MR-DOS/8052-schizoid_demo/PICS/schizoid.png

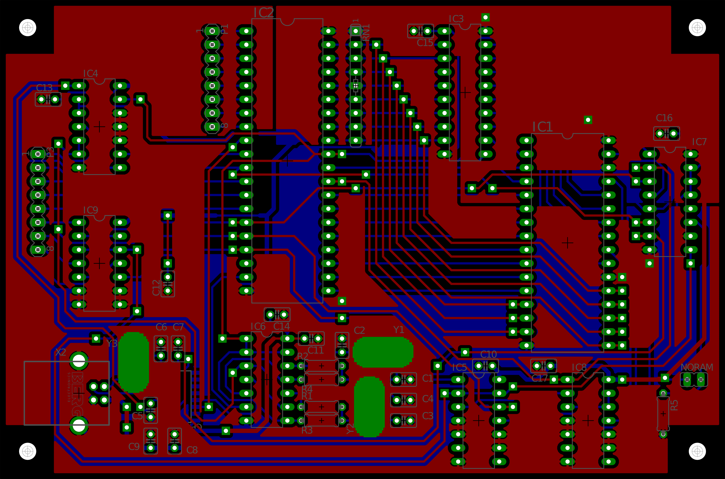
PICS/schizoid.png
