MR-DOS/8052-schizoid_demo/HW_makedata/board_preview.pdf

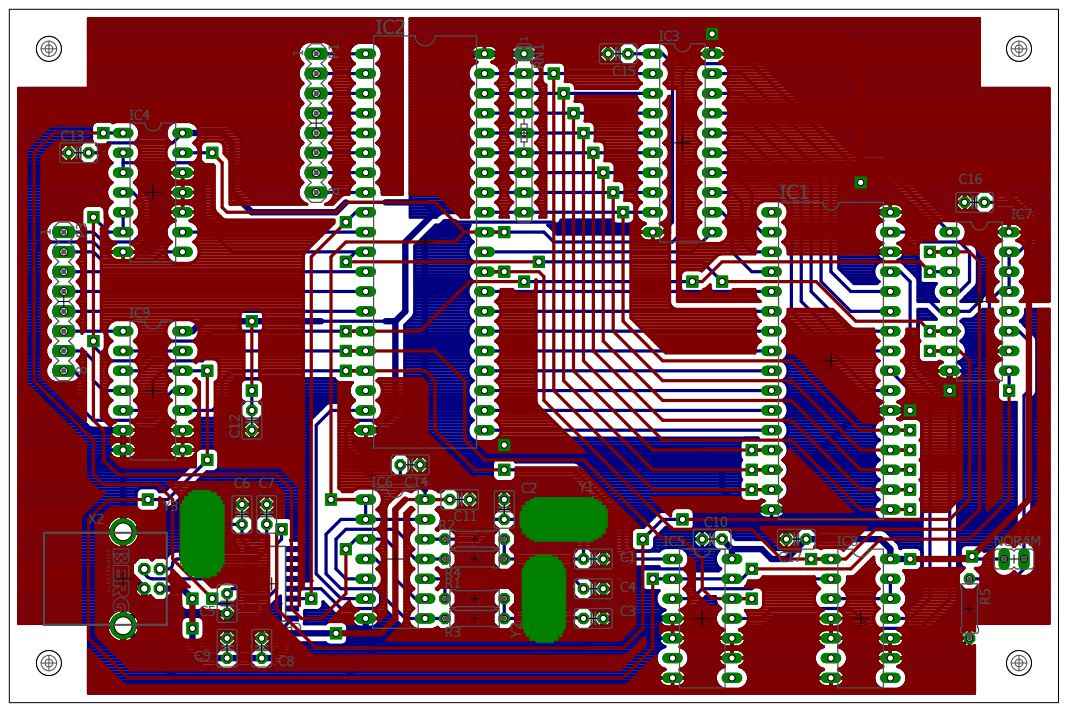
[picture p3: page 1]
