MR-DOS/8052-schizoid_demo/HW_makedata/pcb_placement.pdf

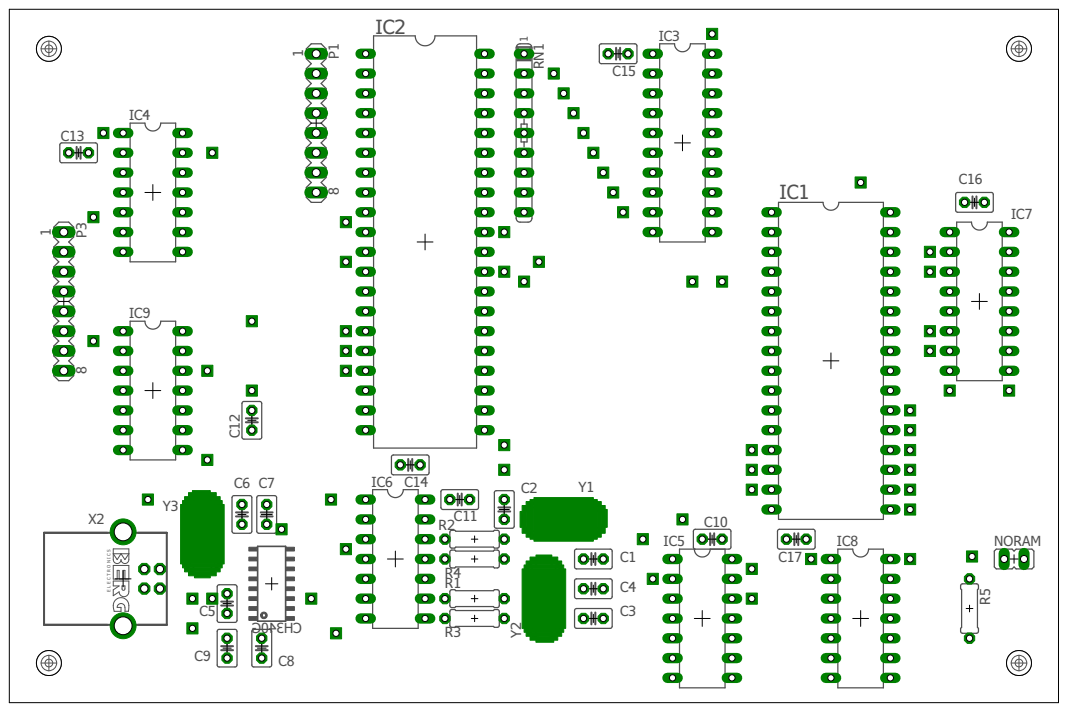
[picture p4: page 1]
