MR-DOS/8052-schizoid_demo/HW_makedata/pcb_top_bottom.pdf

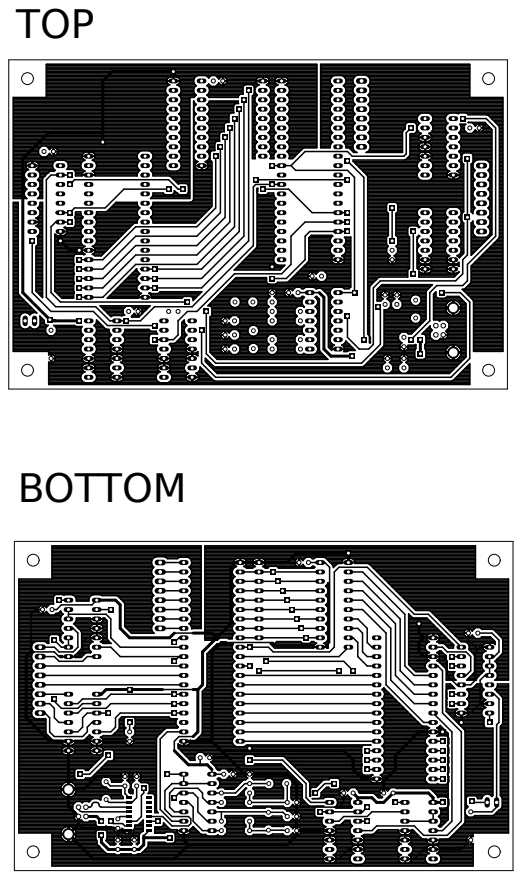
[picture p5: page 1]
TOP; BOTTOM
