MR-DOS/8052-schizoid_demo/HW_makedata/schematics.pdf

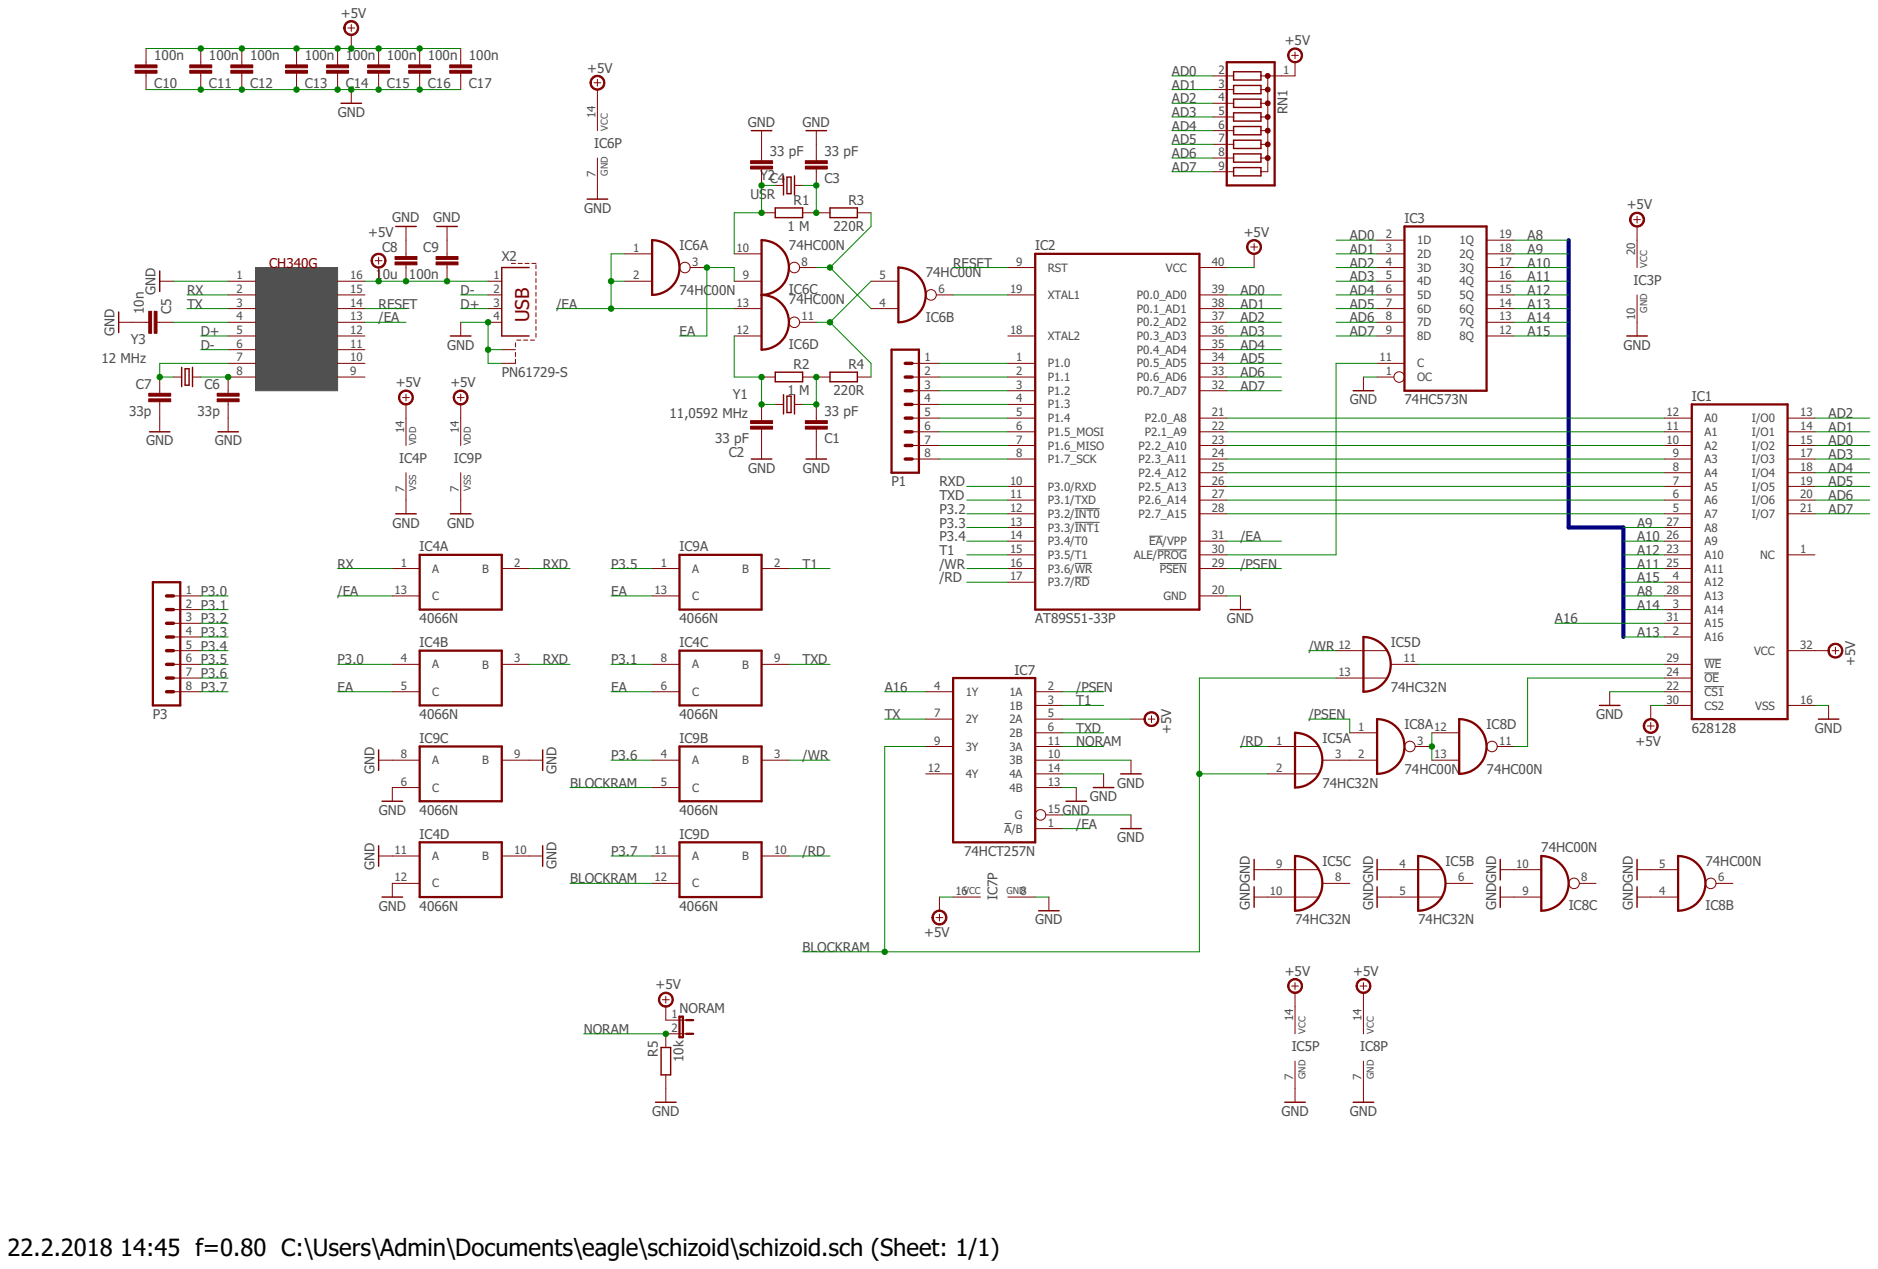
[picture p6: page 1]

22.2.2018 14:45 f=0.80 C:\Users\Admin\Documents\eagle\schizoid\schizoid.sch (Sheet: 1/1)
