MR-DOS/8052-schizoid_demo/HW_eagle/schizoid.brd

## EAGLE design HW_eagle/schizoid.brd (2018-03-31)

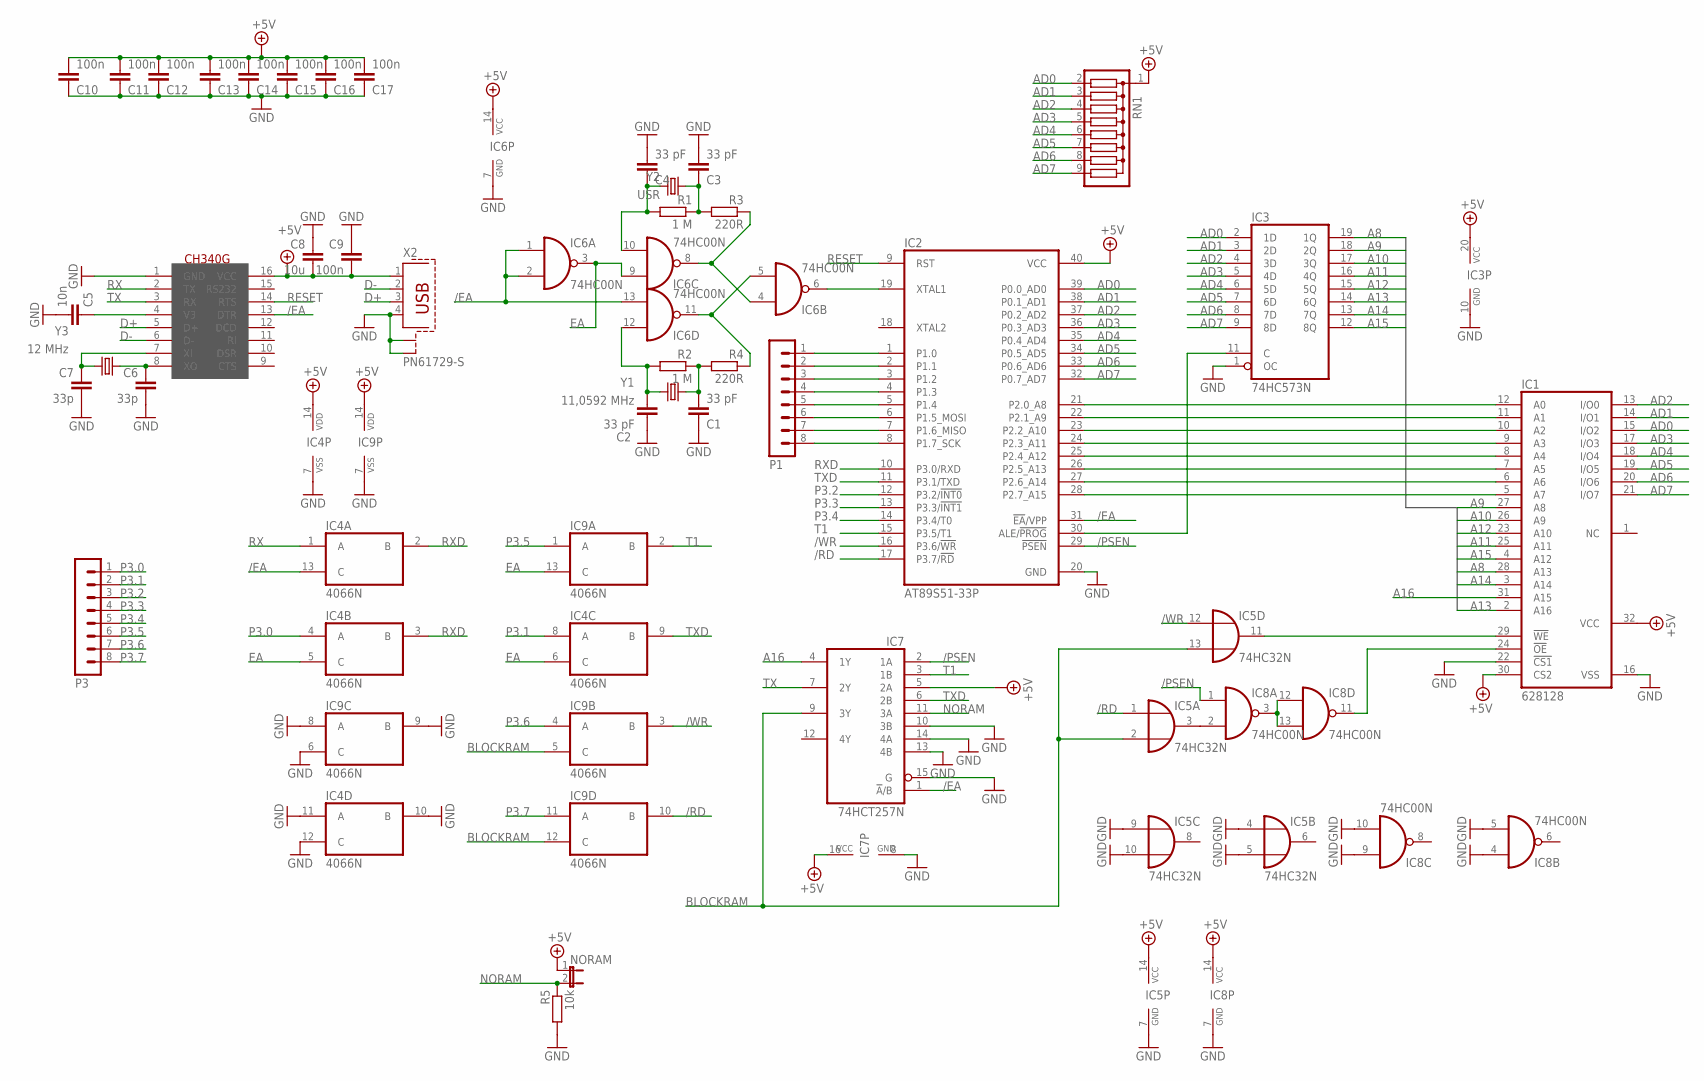
[picture p7: schematic schizoid.sch]

Parts:
C1, C2, C3, C4: 33 pF; C025-025X050
C5: 10n; C025-025X050
C6, C7: 33p; C025-025X050
C8: 10u; C025-025X050
C9, C10, C11, C12, C13, C14, C15, C16, C17: 100n; C025-025X050
IC1: 628128; DIL32
IC2: AT89S51-33P; DIL40
IC3: 74HC573N; DIL20
IC4, IC9: 4066N; DIL14
IC5: 74HC32N; DIL14
IC6, IC8: 74HC00N; DIL14
IC7: 74HCT257N; DIL16
NORAM: JP1E; JP1
P1, P3: MA08-1
R1, R2: 1 M; 0207/7
R3, R4: 220R; 0207/7
R5: 10k; 0207/7
RN1: G08R; SIL9
U$1: CH340G; SOIC16
X2: PN61729-S
Y1: 11,0592 MHz; HC49U-V
Y2: USR; HC49U-V
Y3: 12 MHz; HC49U-V

Connections:
+5V: C8.2, C9.2, C10.2, C11.2, C12.2, C13.2, C14.2, C15.2, C16.2, C17.2, IC1.30 (CS2), IC1.32 (VCC), IC2.40 (VCC), IC3.20 (VCC), IC4.14 (VDD), IC5.14 (VCC), IC6.14 (VCC), IC7.5 (2A), IC7.16 (VCC), IC8.14 (VCC), IC9.14 (VDD), NORAM.1, RN1.1, U$1.16 (VCC), X2.1
/EA: IC2.31 (!EA!/VPP), IC4.13 (C), IC6.1 (I0), IC6.2 (I1), IC6.13 (I1), IC7.1 (!A!/B), U$1.13 (DTR)
/PSEN: IC2.29 (!PSEN), IC7.2 (1A), IC8.1 (I0)
/RD: IC2.17 (P3.7/!RD), IC5.1 (I0), IC9.10 (B)
/WR: IC2.16 (P3.6/!WR), IC5.12 (I0), IC9.3 (B)
A8: IC1.28 (A13), IC3.19 (1Q)
A9: IC1.27 (A8), IC3.18 (2Q)
A10: IC1.26 (A9), IC3.17 (3Q)
A11: IC1.25 (A11), IC3.16 (4Q)
A12: IC1.23 (A10), IC3.15 (5Q)
A13: IC1.2 (A16), IC3.14 (6Q)
A14: IC1.3 (A14), IC3.13 (7Q)
A15: IC1.4 (A12), IC3.12 (8Q)
A16: IC1.31 (A15), IC7.4 (1Y)
AD0: IC1.15 (I/O2), IC2.39 (P0.0_AD0), IC3.2 (1D), RN1.2
AD1: IC1.14 (I/O1), IC2.38 (P0.1_AD1), IC3.3 (2D), RN1.3
AD2: IC1.13 (I/O0), IC2.37 (P0.2_AD2), IC3.4 (3D), RN1.4
AD3: IC1.17 (I/O3), IC2.36 (P0.3_AD3), IC3.5 (4D), RN1.5
AD4: IC1.18 (I/O4), IC2.35 (P0.4_AD4), IC3.6 (5D), RN1.6
AD5: IC1.19 (I/O5), IC2.34 (P0.5_AD5), IC3.7 (6D), RN1.7
AD6: IC1.20 (I/O6), IC2.33 (P0.6_AD6), IC3.8 (7D), RN1.8
AD7: IC1.21 (I/O7), IC2.32 (P0.7_AD7), IC3.9 (8D), RN1.9
BLOCKRAM: IC5.2 (I1), IC5.13 (I1), IC7.9 (3Y), IC9.5 (C), IC9.12 (C)
D+: U$1.5 (D+), X2.3
D-: U$1.6 (D-), X2.2
EA: IC4.5 (C), IC4.6 (C), IC6.3 (O), IC6.9 (I0), IC9.13 (C)
GND: C1.1, C2.1, C3.2, C4.2, C5.2, C6.2, C7.2, C8.1, C9.1, C10.1, C11.1, C12.1, C13.1, C14.1, C15.1, C16.1, C17.1, IC1.16 (VSS), IC1.22 (!CS1), IC2.20 (GND), IC3.1 (OC), IC3.10 (GND), IC4.7 (VSS), IC4.10 (B), IC4.11 (A), IC4.12 (C), IC5.4 (I0), IC5.5 (I1), IC5.7 (GND), IC5.9 (I0), IC5.10 (I1), IC6.7 (GND), IC7.8 (GND), IC7.10 (3B), IC7.13 (4B), IC7.14 (4A), IC7.15 (G), IC8.4 (I0), IC8.5 (I1), IC8.7 (GND), IC8.9 (I0), IC8.10 (I1), IC9.6 (C), IC9.7 (VSS), IC9.8 (A), IC9.9 (B), R5.2, U$1.1 (GND), X2.4, X2.S1, X2.S2
unnamed: IC1.12 (A0), IC2.21 (P2.0_A8)
unnamed: IC1.11 (A1), IC2.22 (P2.1_A9)
unnamed: IC1.10 (A2), IC2.23 (P2.2_A10)
unnamed: IC1.9 (A3), IC2.24 (P2.3_A11)
unnamed: IC1.8 (A4), IC2.25 (P2.4_A12)
unnamed: IC1.7 (A5), IC2.26 (P2.5_A13)
unnamed: IC1.6 (A6), IC2.27 (P2.6_A14)
unnamed: IC1.5 (A7), IC2.28 (P2.7_A15)
unnamed: IC2.30 (ALE/!PROG), IC3.11 (C)
unnamed: C3.1, R1.1, R3.2, Y2.1
unnamed: IC2.1 (P1.0), P1.1
unnamed: C1.2, R2.1, R4.2, Y1.1
unnamed: IC2.2 (P1.1), P1.2
unnamed: IC2.3 (P1.2), P1.3
unnamed: IC2.4 (P1.3), P1.4
unnamed: IC2.5 (P1.4), P1.5
unnamed: IC2.6 (P1.5_MOSI), P1.6
unnamed: IC2.7 (P1.6_MISO), P1.7
unnamed: IC5.3 (O), IC8.2 (I1)
unnamed: IC6.4 (I0), IC6.8 (O), R3.1
unnamed: IC8.3 (O), IC8.12 (I0), IC8.13 (I1)
unnamed: IC6.5 (I1), IC6.11 (O), R4.1
unnamed: C2.2, IC6.12 (I0), R2.2, Y1.2
unnamed: IC2.8 (P1.7_SCK), P1.8
unnamed: C4.1, IC6.10 (I1), R1.2, Y2.2
unnamed: IC2.19 (XTAL1), IC6.6 (O)
unnamed: C5.1, U$1.4 (V3)
unnamed: C6.1, U$1.8 (XO), Y3.1
unnamed: C7.1, U$1.7 (XI), Y3.2
unnamed: IC1.29 (!WE), IC5.11 (O)
unnamed: IC1.24 (!OE), IC8.11 (O)
NORAM: IC7.11 (3A), NORAM.2, R5.1
P3.0: IC4.4 (A), P3.1
P3.1: IC4.8 (A), P3.2
P3.2: IC2.12 (P3.2/!INT0), P3.3
P3.3: IC2.13 (P3.3/!INT1), P3.4
P3.4: IC2.14 (P3.4/T0), P3.5
P3.5: IC9.1 (A), P3.6
P3.6: IC9.4 (A), P3.7
P3.7: IC9.11 (A), P3.8
RESET: IC2.9 (RST), U$1.14 (RTS)
RX: IC4.1 (A), U$1.2 (TX)
RXD: IC2.10 (P3.0/RXD), IC4.2 (B), IC4.3 (B)
T1: IC2.15 (P3.5/T1), IC7.3 (1B), IC9.2 (B)
TX: IC7.7 (2Y), U$1.3 (RX)
TXD: IC2.11 (P3.1/TXD), IC4.9 (B), IC7.6 (2B)

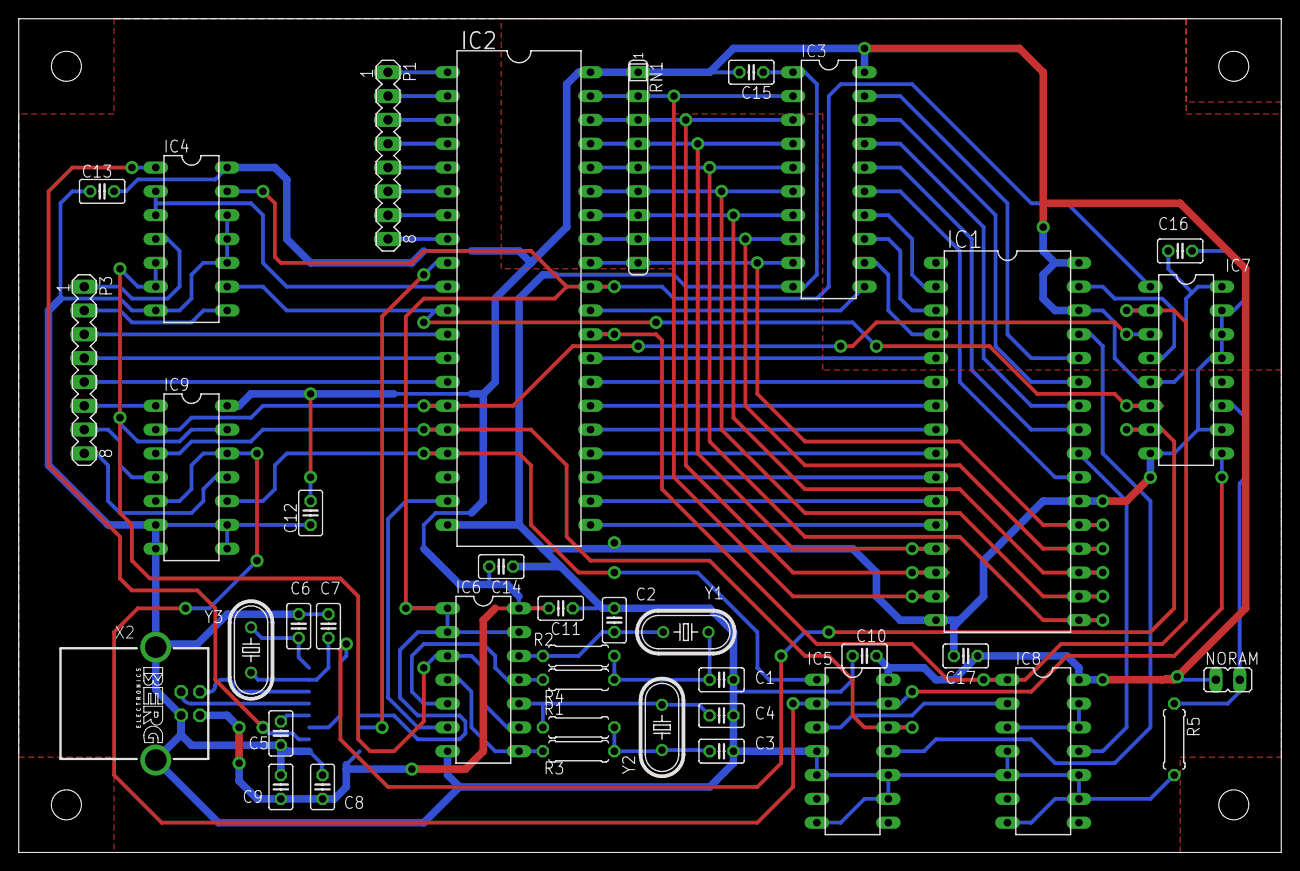
[picture p8: board schizoid.brd from above]

Board: 2 copper layers, 134.6 x 88.9 mm, 40 parts (1 on the bottom side), 73 nets.
